louismeuret/ROBRO/README.md

# ROBRO
To install toolchain, use sudo apt install gcc-arm-none-eabi binutils-arm-none-eabi libnewlib-arm-none-eabi
Then in the folder, write make
