louismeuret/ROBRO/mdrive/mdrive.kicad_pcb

## KiCad design mdrive/mdrive.kicad_pcb (2026-07-22)

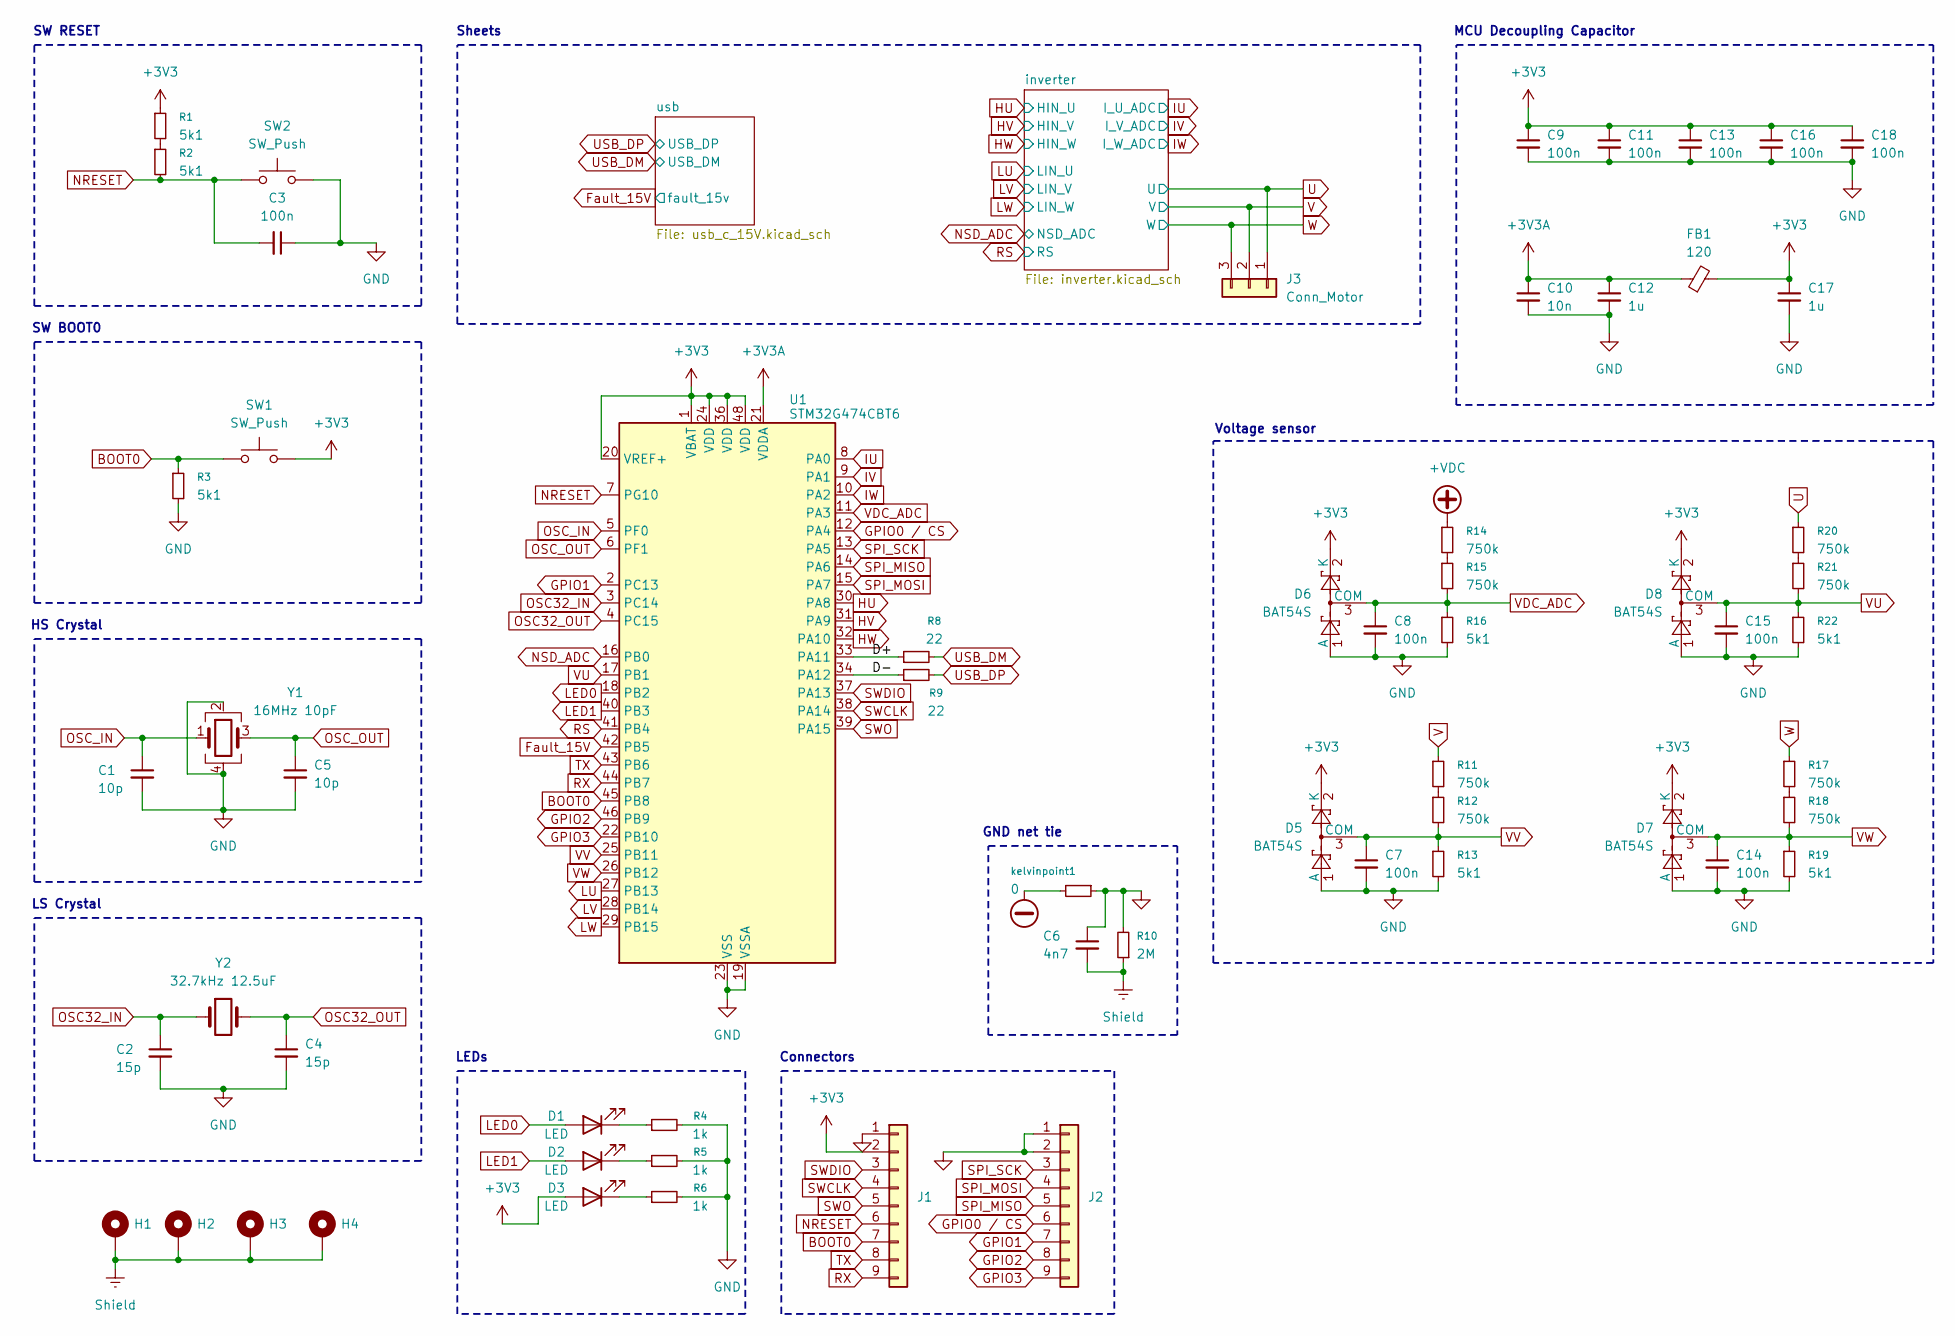
[picture p1: schematic mdrive.kicad_sch, 600v 5A motor driver]

Parts:
C1, C5: 10p; C_0603_1608Metric_Pad1.08x0.95mm_HandSolder
C2, C4: 15p; C_0603_1608Metric_Pad1.08x0.95mm_HandSolder
C3, C7, C8, C9, C11, C13, C14, C15, C16, C18: 100n; C_0603_1608Metric_Pad1.08x0.95mm_HandSolder
C6: 4n7; C_0603_1608Metric_Pad1.08x0.95mm_HandSolder
C10: 10n; C_0603_1608Metric_Pad1.08x0.95mm_HandSolder
C12, C17: 1u; C_0603_1608Metric_Pad1.08x0.95mm_HandSolder
D1, D2, D3: LED; LED_0805_2012Metric_Pad1.15x1.40mm_HandSolder
D5, D6, D7, D8: BAT54S; SOT-23
FB1: 120; R_0603_1608Metric_Pad0.98x0.95mm_HandSolder
H1, H2, H3, H4: MountingHole; MountingHole_4.3mm_M4_DIN965_Pad_TopBottom
J1, J2: Conn_01x09; PinHeader_1x09_P2.54mm_Vertical
J3: Conn_Motor; 3POS_3.5_TH
R1, R2, R3: 5k1; R_0603_1608Metric_Pad0.98x0.95mm_HandSolder
R4, R5, R6: 1k; R_0603_1608Metric_Pad0.98x0.95mm_HandSolder
R8, R9: 22; R_0603_1608Metric_Pad0.98x0.95mm_HandSolder
R10: 2M; R_1206_3216Metric_Pad1.30x1.75mm_HandSolder
R11, R12, R14, R15, R17, R18, R20, R21: 750k; R_1206_3216Metric_Pad1.30x1.75mm_HandSolder
R13, R16, R19, R22: 5k1; R_1206_3216Metric_Pad1.30x1.75mm_HandSolder
SW1, SW2: SW_Push; SW_SPST_TL3342
U1: STM32G474CBT6; LQFP-48_7x7mm_P0.5mm
Y1: 16MHz 10pF; Crystal_SMD_3225-4Pin_3.2x2.5mm_HandSoldering
Y2: 32.7kHz 12.5uF; Crystal_SMD_3215-2Pin_3.2x1.5mm
kelvinpoint1: 0; NetTie-2_SMD_Pad2.0mm

Connections:
+3V3: C9.1, C11.1, C13.1, C16.1, C17.1, C18.1, D3.2 (A), D5.2 (K), D6.2 (K), D7.2 (K), D8.2 (K), FB1.2, J1.2, R1.1, SW1.2, U1.1 (VBAT), U1.20 (VREF+), U1.24 (VDD), U1.36 (VDD), U1.48 (VDD); also elsewhere on the board
+3V3A: C10.1, C12.1, FB1.1, U1.21 (VDDA)
-VDC: kelvinpoint1.2; also elsewhere on the board
/D+: R8.1, U1.33 (PA11)
/D-: R9.1, U1.34 (PA12)
BOOT0: J1.7, R3.1, SW1.1, U1.45 (PB8)
Fault_15V: U1.42 (PB5); also elsewhere on the board
GND: C1.2, C2.2, C3.1, C4.2, C5.2, C6.1, C7.2, C8.2, C9.2, C10.2, C11.2, C12.2, C13.2, C14.2, C15.2, C16.2, C17.2, C18.2, D5.1 (A), D6.1 (A), D7.1 (A), D8.1 (A), J1.1, J2.1, J2.2, R3.2, R4.2, R5.2, R6.2, R10.2, R13.2, R16.2, R19.2, R22.2, SW2.2, U1.19 (VSSA), U1.23 (VSS), U1.35 (VSS), U1.47 (VSS), Y1.2 (G), Y1.4 (G), kelvinpoint1.1; also elsewhere on the board
GPIO0 / CS: J2.6, U1.12 (PA4)
GPIO1: J2.7, U1.2 (PC13)
GPIO2: J2.8, U1.46 (PB9)
GPIO3: J2.9, U1.22 (PB10)
HU: U1.30 (PA8); also elsewhere on the board
HV: U1.31 (PA9); also elsewhere on the board
HW: U1.32 (PA10); also elsewhere on the board
IU: U1.8 (PA0); also elsewhere on the board
IV: U1.9 (PA1); also elsewhere on the board
IW: U1.10 (PA2); also elsewhere on the board
LED0: D1.2 (A), U1.18 (PB2); also elsewhere on the board
LED1: D2.2 (A), U1.40 (PB3)
LU: U1.27 (PB13); also elsewhere on the board
LV: U1.28 (PB14); also elsewhere on the board
LW: U1.29 (PB15); also elsewhere on the board
NRESET: C3.2, J1.6, R2.2, SW2.1, U1.7 (PG10)
NSD_ADC: U1.16 (PB0); also elsewhere on the board
unnamed: D1.1 (K), R4.1
unnamed: D2.1 (K), R5.1
unnamed: D3.1 (K), R6.1
unnamed: R1.2, R2.1
unnamed 45: R11.2, R12.1; also elsewhere on the board
unnamed 46: R14.2, R15.1; also elsewhere on the board
unnamed 47: R17.2, R18.1; also elsewhere on the board
unnamed 48: R20.2, R21.1; also elsewhere on the board
OSC32_IN: C2.1, U1.3 (PC14), Y2.1
OSC32_OUT: C4.1, U1.4 (PC15), Y2.2
OSC_IN: C1.1, U1.5 (PF0), Y1.1
OSC_OUT: C5.1, U1.6 (PF1), Y1.3
RS: U1.41 (PB4); also elsewhere on the board
RX: J1.9, U1.44 (PB7)
SPI_MISO: J2.5, U1.14 (PA6)
SPI_MOSI: J2.4, U1.15 (PA7)
SPI_SCK: J2.3, U1.13 (PA5)
SWCLK: J1.4, U1.38 (PA14)
SWDIO: J1.3, U1.37 (PA13)
SWO: J1.5, U1.39 (PA15)
Shield: C6.2, H1.1 (1_1), H2.1 (1_1), H3.1 (1_1), H4.1 (1_1), R10.1; also elsewhere on the board
TX: J1.8, U1.43 (PB6)
U: J3.1, R20.1; also elsewhere on the board
USB_DM: R8.2; also elsewhere on the board
USB_DP: R9.2; also elsewhere on the board
V: J3.2, R11.1; also elsewhere on the board
VDC_ADC: C8.1, D6.3 (COM), R15.2, R16.1, U1.11 (PA3)
VU: C15.1, D8.3 (COM), R21.2, R22.1, U1.17 (PB1)
VV: C7.1, D5.3 (COM), R12.2, R13.1, U1.25 (PB11)
VW: C14.1, D7.3 (COM), R18.2, R19.1, U1.26 (PB12); also elsewhere on the board
W: J3.3, R17.1; also elsewhere on the board

Notes on the sheet:
MCU Decoupling Capacitor
GND net tie
Connectors
Voltage sensor
LS Crystal
Sheets
LEDs
SW BOOT0
SW RESET
HS Crystal

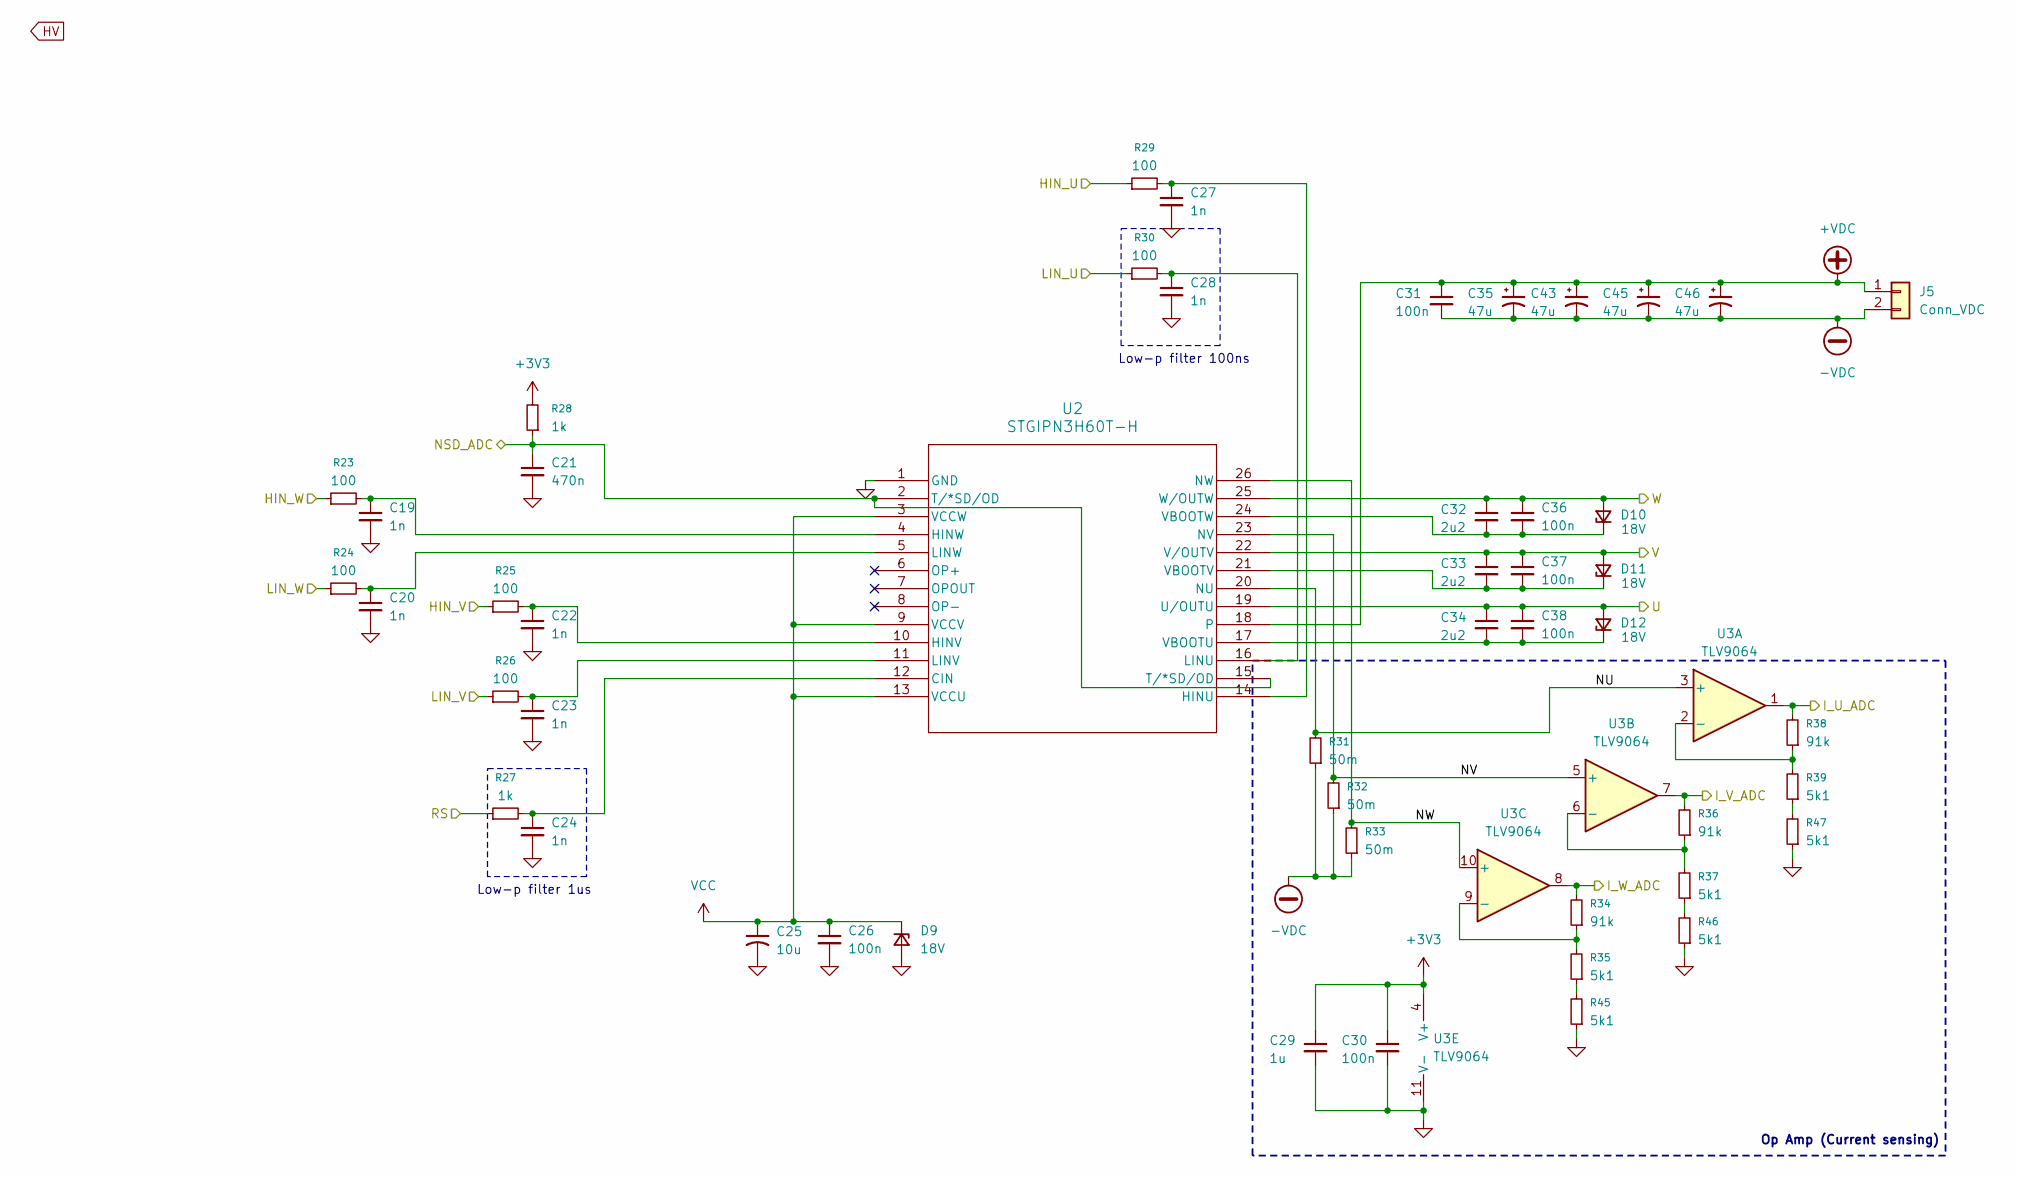
[picture p2: schematic inverter.kicad_sch, 600v 5A motor driver]

Parts:
C19, C20, C22, C23, C24, C27, C28: 1n; C_0603_1608Metric_Pad1.08x0.95mm_HandSolder
C21: 470n; C_0603_1608Metric_Pad1.08x0.95mm_HandSolder
C25: 10u; C_0603_1608Metric_Pad1.08x0.95mm_HandSolder
C26, C30: 100n; C_0603_1608Metric_Pad1.08x0.95mm_HandSolder
C29: 1u; C_0603_1608Metric_Pad1.08x0.95mm_HandSolder
C31, C36, C37, C38: 100n; C_1206_3216Metric_Pad1.33x1.80mm_HandSolder
C32, C33, C34: 2u2; C_1206_3216Metric_Pad1.33x1.80mm_HandSolder
C35, C43, C45, C46: 47u; CP_Radial_D10.0mm_P5.00mm
D9, D10, D11, D12: 18V; D_SOD-123
J5: Conn_VDC; DB301V-3.5-2P-GN-S
R23, R24, R25, R26, R29, R30: 100; R_0603_1608Metric_Pad0.98x0.95mm_HandSolder
R27, R28: 1k; R_0603_1608Metric_Pad0.98x0.95mm_HandSolder
R31, R32, R33: 50m; R_1206_3216Metric_Pad1.30x1.75mm_HandSolder
R34, R36, R38: 91k; R_0603_1608Metric_Pad0.98x0.95mm_HandSolder
R35, R37, R39, R45, R46, R47: 5k1; R_0603_1608Metric_Pad0.98x0.95mm_HandSolder
U2: STGIPN3H60T-H; NDIP-26_12P55X29P25_STM
U3: TLV9064; SOIC-14_3.9x8.7mm_P1.27mm

Connections:
+3V3: C29.1, C30.1, R28.2, U3.4 (V+); also elsewhere on the board
+VDC: C31.1, C35.1, C43.1, C45.1, C46.1, J5.1, U2.18; also elsewhere on the board
-VDC: C31.2, C35.2, C43.2, C45.2, C46.2, J5.2, R31.1, R32.1, R33.1; also elsewhere on the board
/inverter/NU: R31.2, U2.20 (NU), U3.3 (+)
/inverter/NV: R32.2, U2.23 (NV), U3.5 (+)
/inverter/NW: R33.2, U2.26 (NW), U3.10 (+)
GND: C19.2, C20.2, C21.2, C22.2, C23.2, C24.2, C25.2, C26.2, C27.2, C28.2, C29.2, C30.2, D9.2 (A), R45.1, R46.1, R47.1, U2.1 (GND), U3.11 (V-); also elsewhere on the board
HU: R29.1; also elsewhere on the board
HV: R25.1; also elsewhere on the board
HW: R23.1; also elsewhere on the board
IU: R38.2, U3.1; also elsewhere on the board
IV: R36.2, U3.7; also elsewhere on the board
IW: R34.2, U3.8; also elsewhere on the board
LV: R26.1; also elsewhere on the board
LW: R24.1; also elsewhere on the board
NSD_ADC: C21.1, R28.1, U2.2 (T/*SD/OD), U2.15 (T/*SD/OD); also elsewhere on the board
unnamed: C32.2, C36.2, D10.1 (K), U2.24 (VBOOTW)
unnamed: C33.2, C37.2, D11.1 (K), U2.21 (VBOOTV)
unnamed: C34.2, C38.2, D12.1 (K), U2.17 (VBOOTU)
unnamed: R35.1, R45.2
unnamed: R37.1, R46.2
unnamed: R39.1, R47.2
unnamed: C24.1, R27.2, U2.12 (CIN)
unnamed: C27.1, R29.2, U2.14 (HINU)
unnamed: C22.1, R25.2, U2.10 (HINV)
unnamed: C19.1, R23.2, U2.4 (HINW)
unnamed 56: C28.1, R30.2, U2.16 (LINU); also elsewhere on the board
unnamed: C23.1, R26.2, U2.11 (LINV)
unnamed: C20.1, R24.2, U2.5 (LINW)
unnamed: R38.1, R39.2, U3.2 (-)
unnamed: R36.1, R37.2, U3.6 (-)
unnamed: R34.1, R35.2, U3.9 (-)
RS: R27.1; also elsewhere on the board
U: C34.1, C38.1, D12.2 (A), U2.19 (U/OUTU); also elsewhere on the board
V: C33.1, C37.1, D11.2 (A), U2.22 (V/OUTV); also elsewhere on the board
VCC: C25.1, C26.1, D9.1 (K), U2.3 (VCCW), U2.9 (VCCV), U2.13 (VCCU); also elsewhere on the board
W: C32.1, C36.1, D10.2 (A), U2.25 (W/OUTW); also elsewhere on the board

Notes on the sheet:
Low-p filter 100ns
Op Amp (Current sensing)
Low-p filter 1us

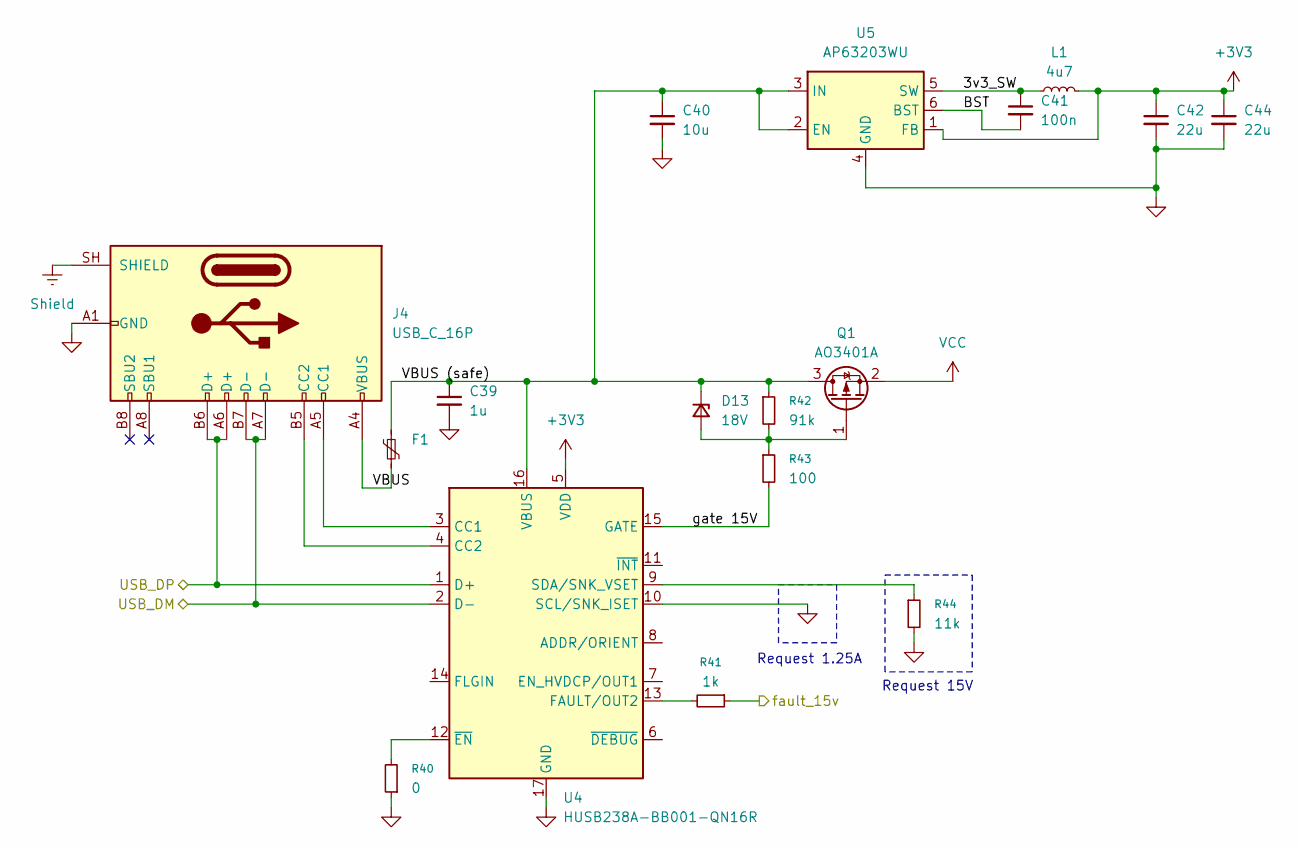
[picture p3: schematic usb_c_15V.kicad_sch, 600v 5A motor driver]

Parts:
C39: 1u; C_0603_1608Metric_Pad1.08x0.95mm_HandSolder
C40: 10u; C_0603_1608Metric_Pad1.08x0.95mm_HandSolder
C41: 100n; C_0603_1608Metric_Pad1.08x0.95mm_HandSolder
C42, C44: 22u; C_0603_1608Metric_Pad1.08x0.95mm_HandSolder
D13: 18V; D_SOD-123
F1: Polyfuse_Small; Fuse_1812_4532Metric_Pad1.30x3.40mm_HandSolder
J4: USB_C_16P; USB_C_Receptacle_HRO_TYPE-C-31-M-12
L1: 4u7; L_Changjiang_FXL0530
Q1: AO3401A; SOT-23
R40: 0; R_0201_0603Metric_Pad0.64x0.40mm_HandSolder
R41: 1k; R_0603_1608Metric_Pad0.98x0.95mm_HandSolder
R42: 91k; R_0603_1608Metric_Pad0.98x0.95mm_HandSolder
R43: 100; R_0603_1608Metric_Pad0.98x0.95mm_HandSolder
R44: 11k; R_0603_1608Metric_Pad0.98x0.95mm_HandSolder
U4: HUSB238A-BB001-QN16R; WQFN-16-1EP_3x3mm_P0.5mm_EP1.75x1.75mm
U5: AP63203WU; TSOT-23-6

Connections:
+3V3: C42.1, C44.1, L1.2, U4.5 (VDD), U5.1 (FB); also elsewhere on the board
/usb/3v3_SW: C41.1, L1.1, U5.5 (SW)
/usb/BST: C41.2, U5.6 (BST)
/usb/VBUS: F1.2, J4.A4 (VBUS), J4.A9 (VBUS), J4.B4 (VBUS), J4.B9 (VBUS)
/usb/VBUS (safe): C39.1, C40.1, D13.1 (K), F1.1, Q1.3 (D), R42.1, U4.16 (VBUS), U5.2 (EN), U5.3 (IN)
/usb/gate 15V: R43.2, U4.15 (GATE)
Fault_15V: R41.1; also elsewhere on the board
GND: C39.2, C40.2, C42.2, C44.2, J4.A1 (GND), J4.A12 (GND), J4.B1 (GND), J4.B12 (GND), R40.1, R44.2, U4.10 (SCL/SNK_ISET), U4.17 (GND), U5.4 (GND); also elsewhere on the board
unnamed: D13.2 (A), Q1.1 (G), R42.2, R43.1
unnamed: J4.A5 (CC1), U4.3 (CC1)
unnamed: J4.B5 (CC2), U4.4 (CC2)
unnamed: R41.2, U4.13 (FAULT/OUT2)
unnamed: R44.1, U4.9 (SDA/SNK_VSET)
unnamed: R40.2, U4.12 (~EN)
Shield: J4.SH (SHIELD); also elsewhere on the board
USB_DM: J4.A7 (D-), J4.B7 (D-), U4.2 (D-); also elsewhere on the board
USB_DP: J4.A6 (D+), J4.B6 (D+), U4.1 (D+); also elsewhere on the board
VCC: Q1.2 (S); also elsewhere on the board

Notes on the sheet:
Request 15V
Request 1.25A

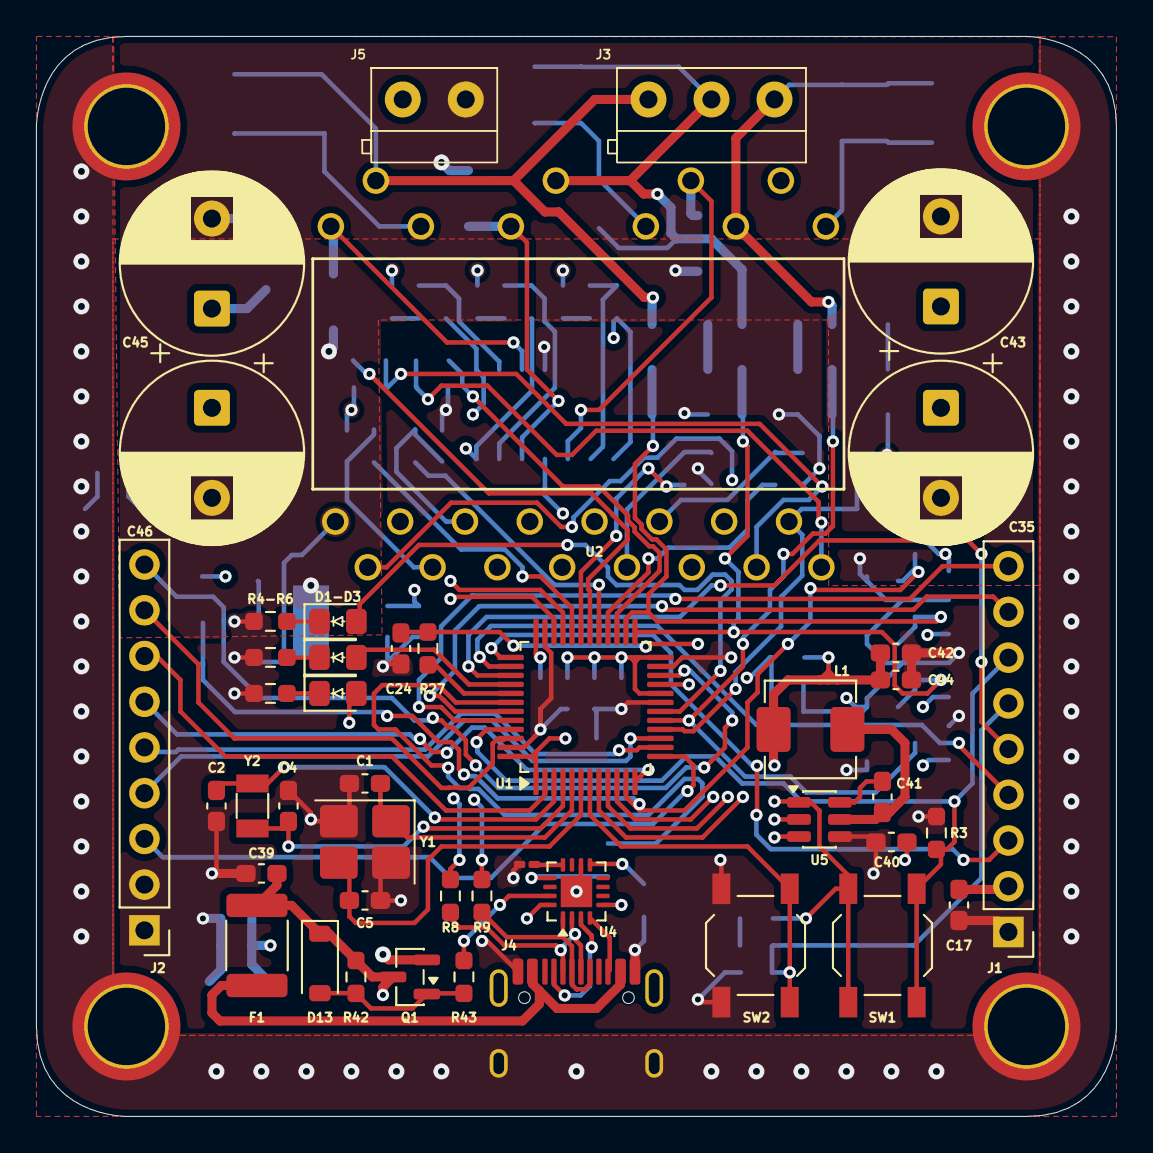
[picture p4: board mdrive.kicad_pcb from above]

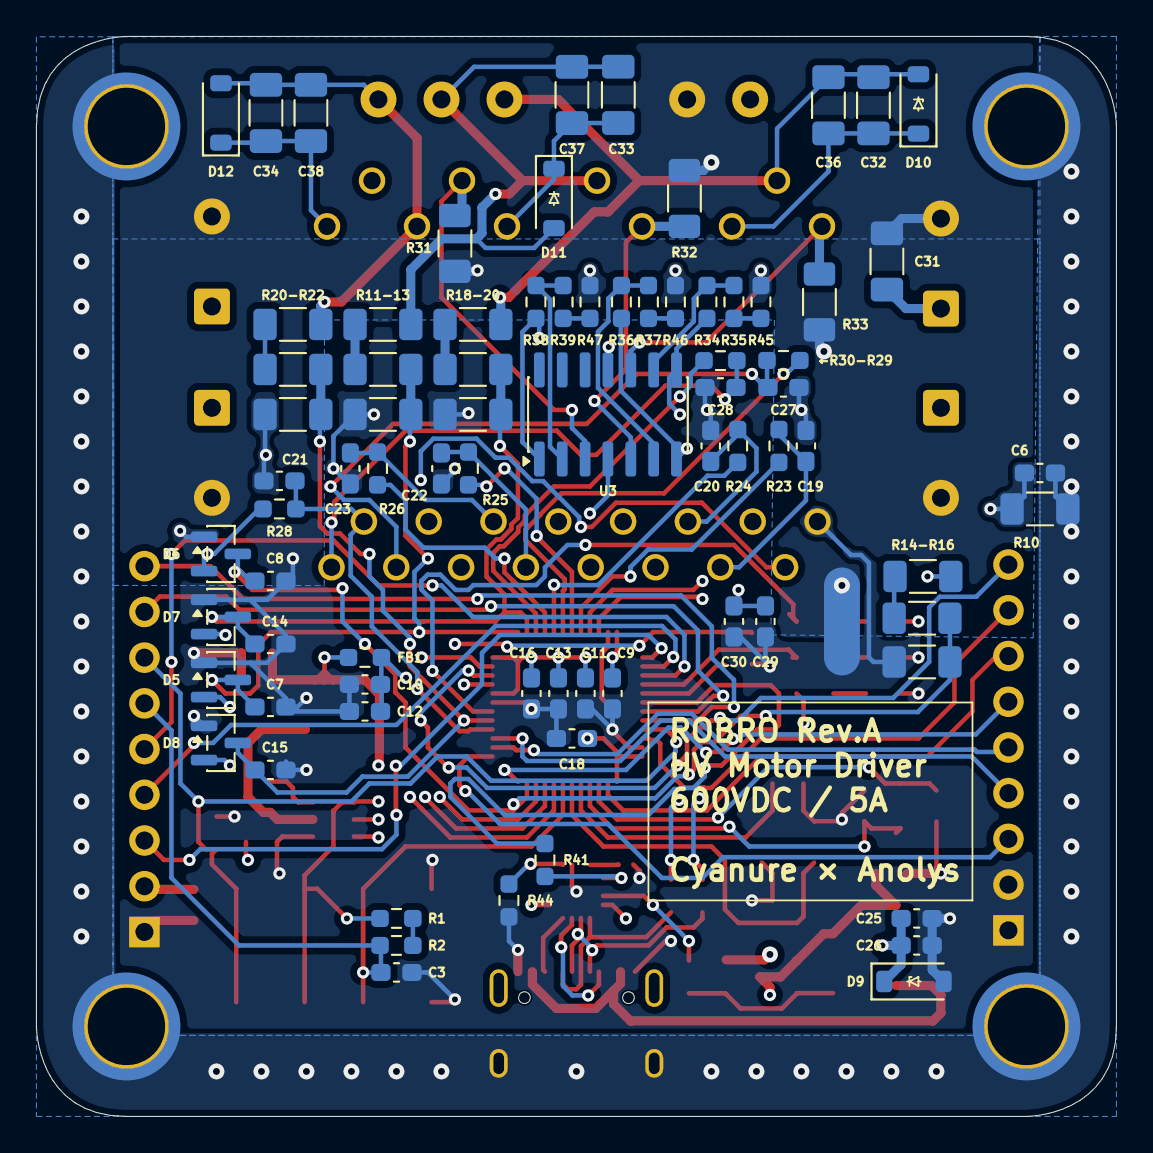
[picture p5: board mdrive.kicad_pcb from below]

Board: 4 copper layers, 60.0 x 60.0 mm, 127 parts (78 on the bottom side), 88 nets.

Other parts of the board:
D1-D3: LED; LED_0805_2012Metric_Pad1.15x1.40mm_HandSolder
R4-R6: 1k; R_0603_1608Metric_Pad0.98x0.95mm_HandSolder
R11-13, R14-R16, R18-20, R20-R22: 750k; R_1206_3216Metric_Pad1.30x1.75mm_HandSolder
←R30-R29: 100; R_0603_1608Metric_Pad0.98x0.95mm_HandSolder

Their connections:
+VDC: R14-R16.1; also elsewhere on the board
GND: R4-R6.2; also elsewhere on the board
LED0: D1-D3.2 (A); also elsewhere on the board
LU: ←R30-R29.1; also elsewhere on the board
unnamed: D1-D3.1 (K), R4-R6.1
unnamed 45: R11-13.2; also elsewhere on the board
unnamed 46: R14-R16.2; also elsewhere on the board
unnamed 47: R18-20.1; also elsewhere on the board
unnamed 48: R20-R22.2; also elsewhere on the board
unnamed 56: ←R30-R29.2; also elsewhere on the board
U: R20-R22.1; also elsewhere on the board
V: R11-13.1; also elsewhere on the board
VW: R18-20.2; also elsewhere on the board
