louismeuret/ROBRO/compilation_version_1/Core/Src/voltage_monitor.c

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
/* Includes ------------------------------------------------------------------*/
#include "main.h"
#include <stdio.h>
#include <string.h>

/* USER CODE BEGIN PD */

/* ADC reference voltage in millivolts (STM32 VDDA / VREF+). */
#define VREF_MV            3300u

/* 12-bit ADC -> full scale count. */
#define ADC_FULL_SCALE     4095u

/* --------------------------------------------------------------------------
 * Input voltage divider in front of PA0 (ADC1_IN1).
 *
 *      USB-C VBUS ---[ R_TOP ]---+--- PA0 (ADC pin, 0..3.3 V max)
 *                                |
 *                             [ R_BOTTOM ]
 *                                |
 *                               GND
 *
 *   Vusb = Vpin * (R_TOP + R_BOTTOM) / R_BOTTOM
 *
 * SET THESE to your actual resistor values (any consistent unit, e.g. kOhm).
 * Defaults below mean "no divider" (R_TOP = 0) -> Vusb is reported equal to
 * the raw pin voltage. With a 5 V or 20 V USB-C rail you MUST add a divider
 * and enter its resistor values here, otherwise the reported volts are wrong.
 * -------------------------------------------------------------------------- */
#define VDIV_R_TOP         0u    /* high-side resistor */
#define VDIV_R_BOTTOM      1u    /* low-side resistor (must be > 0)            */

/* How often to send a reading, in milliseconds. */
#define SAMPLE_PERIOD_MS   200u

/* USER CODE END PD */

ADC_HandleTypeDef hadc1;
UART_HandleTypeDef huart1;

void SystemClock_Config(void);
static void MX_GPIO_Init(void);
static void MX_ADC1_Init(void);
static void MX_USART1_UART_Init(void);

/* USER CODE BEGIN PFP */
static uint32_t ADC_ReadOnce(void);
/* USER CODE END PFP */

/**
  * @brief  The application entry point.
  * @retval int
  */
int main(void)
{
  /* MCU Configuration--------------------------------------------------------*/
  HAL_Init();
  SystemClock_Config();

  /* Initialize only the peripherals this build needs. */
  MX_GPIO_Init();
  MX_ADC1_Init();
  MX_USART1_UART_Init();

  /* USER CODE BEGIN 2 */
  /* Calibrate the ADC once for an accurate reading. */
  HAL_ADCEx_Calibration_Start(&hadc1, ADC_SINGLE_ENDED);

  {
    const char *banner = "USB-C voltage monitor ready\r\n";
    HAL_UART_Transmit(&huart1, (uint8_t *)banner, strlen(banner), HAL_MAX_DELAY);
  }
  /* USER CODE END 2 */

  /* Infinite loop */
  while (1)
  {
    /* USER CODE BEGIN 3 */
    uint32_t adc  = ADC_ReadOnce();

    /* Voltage at the ADC pin, in millivolts. */
    uint32_t vpin_mv = (adc * VREF_MV) / ADC_FULL_SCALE;

    /* Scale back up through the input divider to the real USB-C voltage. */
    uint32_t vusb_mv = vpin_mv * (VDIV_R_TOP + VDIV_R_BOTTOM) / VDIV_R_BOTTOM;

    char line[80];
    int n = snprintf(line, sizeof(line),
                     "VUSB=%lu.%03lu V  (adc=%lu, vpin=%lu mV)\r\n",
                     (unsigned long)(vusb_mv / 1000u),
                     (unsigned long)(vusb_mv % 1000u),
                     (unsigned long)adc,
                     (unsigned long)vpin_mv);
    HAL_UART_Transmit(&huart1, (uint8_t *)line, (uint16_t)n, HAL_MAX_DELAY);

    HAL_Delay(SAMPLE_PERIOD_MS);
    /* USER CODE END 3 */
  }
}

/* USER CODE BEGIN 4 */
/**
  * @brief  Trigger a single ADC conversion and return the raw count.
  * @retval 12-bit ADC value (0..4095)
  */
static uint32_t ADC_ReadOnce(void)
{
  uint32_t value = 0;

  HAL_ADC_Start(&hadc1);
  if (HAL_ADC_PollForConversion(&hadc1, 10u) == HAL_OK)
  {
    value = HAL_ADC_GetValue(&hadc1);
  }
  HAL_ADC_Stop(&hadc1);

  return value;
}
/* USER CODE END 4 */

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
