louismeuret/ROBRO/(commit log)

2026-06-12 Working code for the stm32
2026-07-22 Adding second version compilation
    [Low_p.kicad_sch, bom.csv, designators.csv, inverter.kicad_sch, mdrive.kicad_pcb, mdrive.kicad_sch, positions.csv, usb_c_15V.kicad_sch]
2026-08-07 Telemetry + motor drive overhaul
    Stream VDC/VU/VV/VW and IU/IV/IW over hardware USART2 (PB3) at 57600
    into a Python web dashboard (web_voltages.py, SSE, zoom sliders).
    Firmware:
    - Replace bit-banged PA7 TX with hardware USART2 on PB3
    - Integer fixed-point V/f motor ISR (no FPU), 5 Hz / mod 0.25-0.70
    - Direct-register ADC reads with LL rank switching; fix channel
    encoding, enable ADC2 regulator + deep-power-down exit
    - Wait for in-flight conversion before each ADC read (stale-read fix)
    - Replace sprintf (was ~100 ms/line) with a fast decimal formatter
    - Disable unneeded ADC/USART2 IRQs; remove dead USART1 init
    Tools:
    - Add web_voltages.py live dashboard (voltages + currents, 2 charts)
    - U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
2026-08-30 Adding spi communication with esp32
